ntoutges/GBG_MotorInterface/GBG_Motors.kicad_pcb

## KiCad design GBG_Motors.kicad_pcb (2026-10-02)

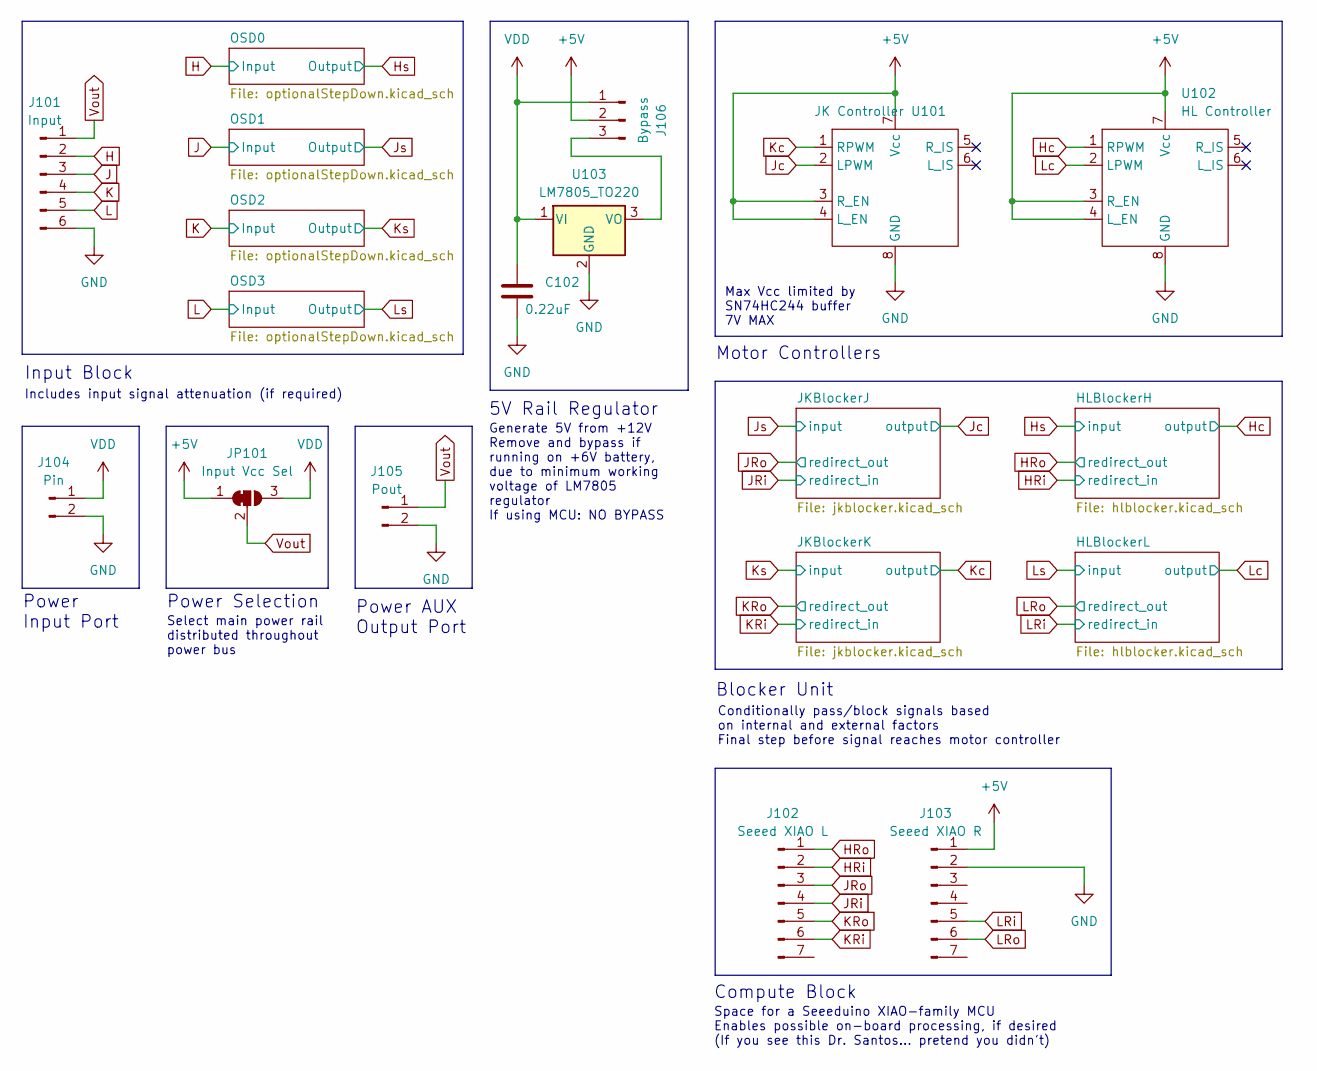
[picture p1: schematic GBG_Motors.kicad_sch]

Parts:
C102: 0.22uF; C_Axial_L3.8mm_D2.6mm_P7.50mm_Horizontal
J101: Input; PinHeader_1x06_P2.54mm_Vertical
J102: Seeed XIAO L; PinHeader_1x07_P2.54mm_Vertical
J103: Seeed XIAO R; PinHeader_1x07_P2.54mm_Vertical
J104: Pin; PinHeader_1x02_P2.54mm_Vertical
J105: Pout; PinHeader_1x02_P2.54mm_Vertical
J106: Bypass; PinHeader_1x03_P2.54mm_Vertical
JP101: Input Vcc Sel; SolderJumper-3_P1.3mm_Bridged12_RoundedPad1.0x1.5mm
U101: JK Controller; BTS7960
U102: HL Controller; BTS7960
U103: LM7805_TO220; TO-220-3_Vertical

Connections:
+5V: J103.1, J106.2, JP101.1 (A), U101.3 (R_EN), U101.4 (L_EN), U101.7 (Vcc), U102.3 (R_EN), U102.4 (L_EN), U102.7 (Vcc); also elsewhere on the board
GND: C102.2, J101.6, J103.2, J104.2, J105.2, U101.8 (GND), U102.8 (GND), U103.2 (GND); also elsewhere on the board
H: J101.2; also elsewhere on the board
HRi: J102.2; also elsewhere on the board
HRo: J102.1; also elsewhere on the board
Hc: U102.1 (RPWM); also elsewhere on the board
J: J101.3; also elsewhere on the board
JRi: J102.4; also elsewhere on the board
JRo: J102.3; also elsewhere on the board
Jc: U101.2 (LPWM); also elsewhere on the board
K: J101.4; also elsewhere on the board
KRi: J102.6; also elsewhere on the board
KRo: J102.5; also elsewhere on the board
Kc: U101.1 (RPWM); also elsewhere on the board
L: J101.5; also elsewhere on the board
LRi: J103.5; also elsewhere on the board
LRo: J103.6; also elsewhere on the board
Lc: U102.2 (LPWM); also elsewhere on the board
unnamed: J106.3, U103.3 (VO)
VDD: C102.1, J104.1, J106.1, JP101.3 (B), U103.1 (VI)
Vout: J101.1, J105.1, JP101.2 (C); also elsewhere on the board

Notes on the sheet:
Compute Block
Conditionally pass/block signals based on internal and external factors Final step before signal reaches motor controller
Input Block
Max Vcc limited by SN74HC244 buffer 7V MAX
Includes input signal attenuation (if required)
Power AUX Output Port
5V Rail Regulator
Space for a Seeeduino XIAO-family MCU Enables possible on-board processing, if desired (If you see this Dr. Santos... pretend you didn't)
Generate 5V from +12V Remove and bypass if running on +6V battery, due to minimum working voltage of LM7805 regulator If using MCU: NO BYPASS
Power Selection
Select main power rail distributed throughout power bus
Blocker Unit
Motor Controllers
Power Input Port

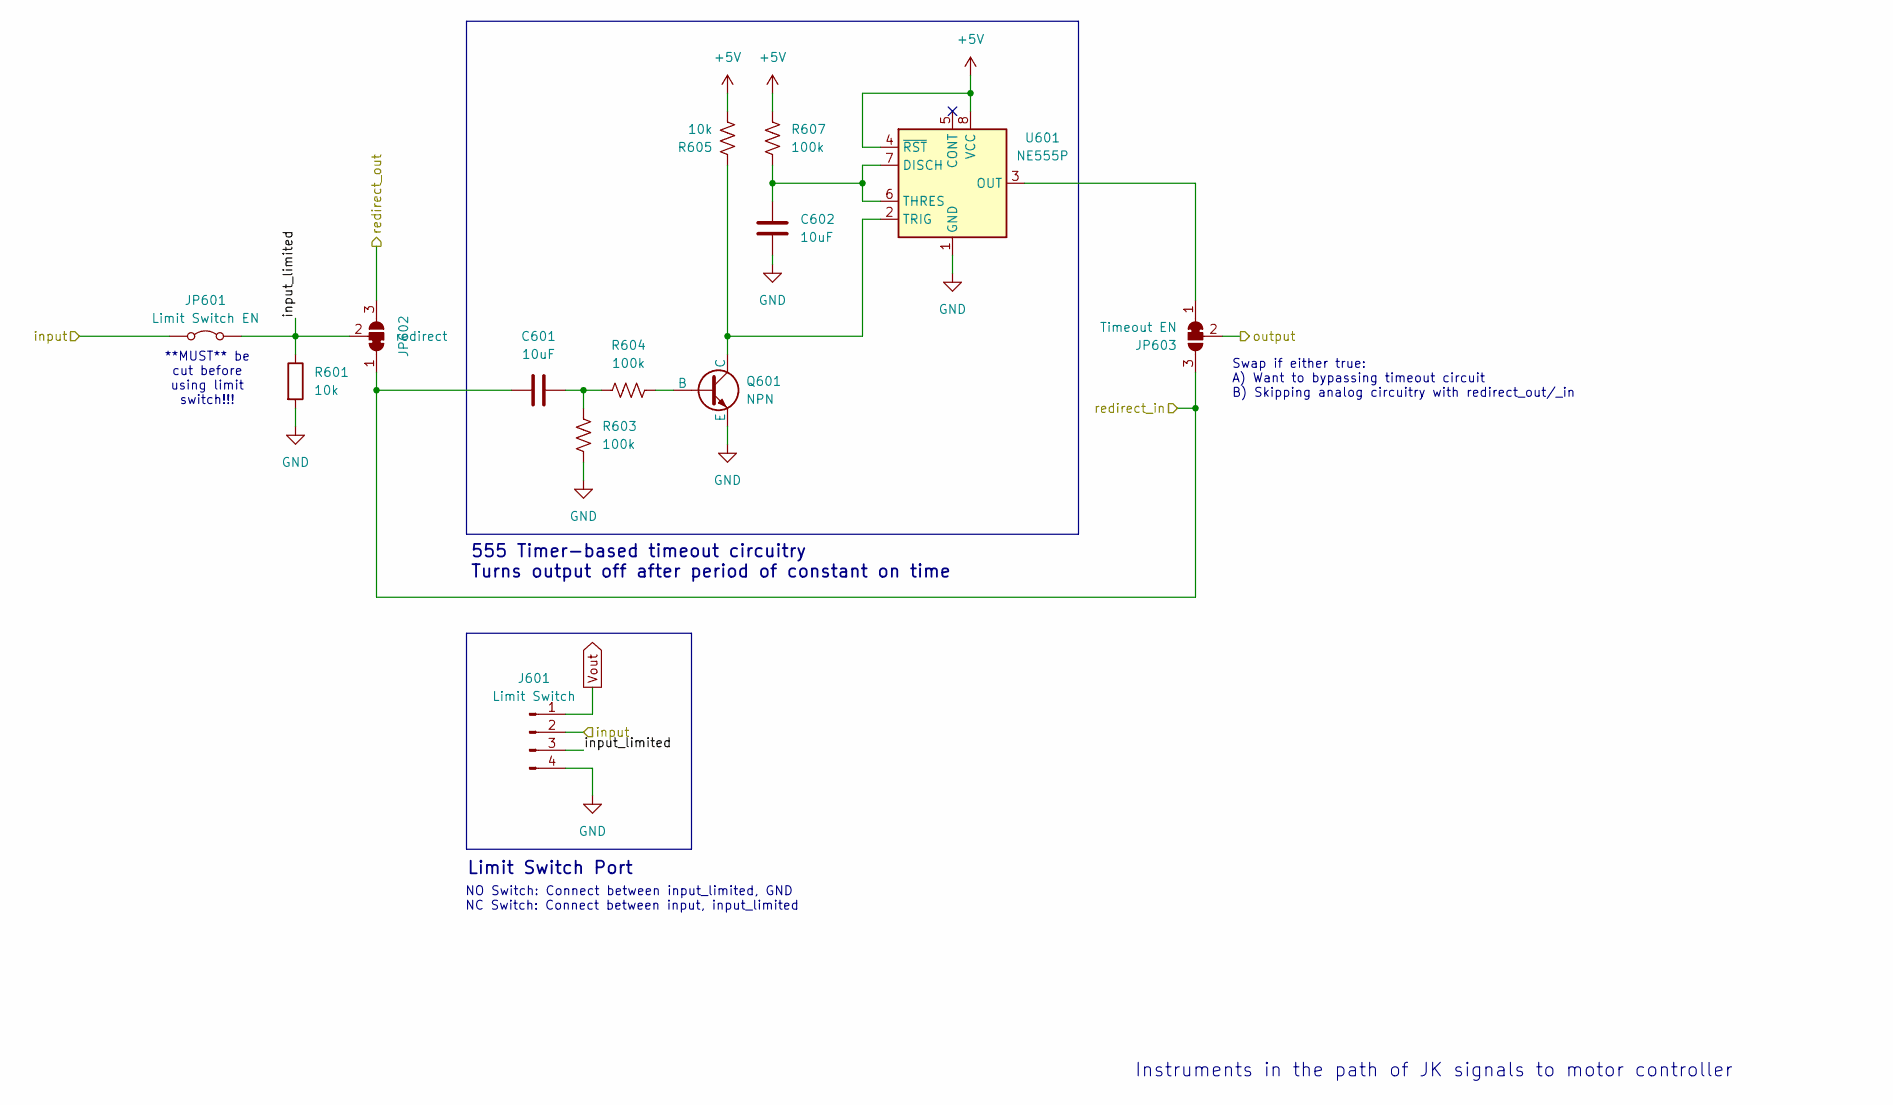
[picture p2: schematic hlblocker.kicad_sch]

Parts:
C601, C602: 10uF; C_Axial_L3.8mm_D2.6mm_P7.50mm_Horizontal
J601: Limit Switch; PinHeader_1x04_P2.54mm_Vertical
JP601: Limit Switch EN; SolderJumper-2_P1.3mm_Bridged_RoundedPad1.0x1.5mm
JP602: redirect; SolderJumper-3_P1.3mm_Bridged12_RoundedPad1.0x1.5mm
JP603: Timeout EN; SolderJumper-3_P1.3mm_Bridged12_RoundedPad1.0x1.5mm
Q601: NPN; TO-92_Wide
R601, R605: 10k; R_Axial_DIN0207_L6.3mm_D2.5mm_P7.62mm_Horizontal
R603, R604, R607: 100k; R_Axial_DIN0207_L6.3mm_D2.5mm_P7.62mm_Horizontal
U601: NE555P; DIP-8_W7.62mm

Connections:
+5V: R605.2, R607.1, U601.4 (~RST), U601.8 (VCC); also elsewhere on the board
/HLBlockerH/input_limited: J601.3, JP601.2 (B), JP602.2 (C), R601.1
GND: C602.2, J601.4, Q601.3 (E), R601.2, R603.2, U601.1 (GND); also elsewhere on the board
HRi: C601.1, JP602.1 (A), JP603.3 (B); also elsewhere on the board
HRo: JP602.3 (B); also elsewhere on the board
Hc: JP603.2 (C); also elsewhere on the board
Hs: J601.2, JP601.1 (A); also elsewhere on the board
unnamed: C601.2, R603.1, R604.1
unnamed: JP603.1 (A), U601.3 (OUT)
unnamed: Q601.2 (B), R604.2
unnamed: Q601.1 (C), R605.1, U601.2 (TRIG)
unnamed: C602.1, R607.2, U601.6 (THRES), U601.7 (DISCH)
Vout: J601.1; also elsewhere on the board

Parts of its further copies:
C701, C702: 10uF; C_Axial_L3.8mm_D2.6mm_P7.50mm_Horizontal
J701: Limit Switch; PinHeader_1x04_P2.54mm_Vertical
JP701: Limit Switch EN; SolderJumper-2_P1.3mm_Bridged_RoundedPad1.0x1.5mm
JP702: redirect; SolderJumper-3_P1.3mm_Bridged12_RoundedPad1.0x1.5mm
JP703: Timeout EN; SolderJumper-3_P1.3mm_Bridged12_RoundedPad1.0x1.5mm
Q701: NPN; TO-92_Wide
R701, R705: 10k; R_Axial_DIN0207_L6.3mm_D2.5mm_P7.62mm_Horizontal
R703, R704, R706: 100k; R_Axial_DIN0207_L6.3mm_D2.5mm_P7.62mm_Horizontal
U701: NE555P; DIP-8_W7.62mm

Connections of its further copies:
+5V: R705.2, R706.1, U701.4 (~RST), U701.8 (VCC); also elsewhere on the board
/HLBlockerL/input_limited: J701.3, JP701.2 (B), JP702.2 (C), R701.1
GND: C702.2, J701.4, Q701.3 (E), R701.2, R703.2, U701.1 (GND); also elsewhere on the board
LRi: C701.1, JP702.1 (A), JP703.3 (B); also elsewhere on the board
LRo: JP702.3 (B); also elsewhere on the board
Lc: JP703.2 (C); also elsewhere on the board
Ls: J701.2, JP701.1 (A); also elsewhere on the board
unnamed: C701.2, R703.1, R704.1
unnamed: JP703.1 (A), U701.3 (OUT)
unnamed: Q701.2 (B), R704.2
unnamed: Q701.1 (C), R705.1, U701.2 (TRIG)
unnamed: C702.1, R706.2, U701.6 (THRES), U701.7 (DISCH)
Vout: J701.1; also elsewhere on the board

Notes on the sheet:
**MUST** be cut before using limit switch!!!
555 Timer-based timeout circuitry Turns output off after period of constant on time
Instruments in the path of JK signals to motor controller
NO Switch: Connect between input_limited, GND NC Switch: Connect between input, input_limited
Limit Switch Port
Swap if either true: A) Want to bypassing timeout circuit B) Skipping analog circuitry with redirect_out/_in

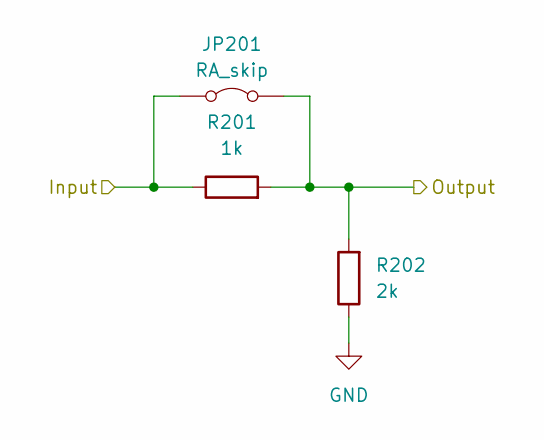
[picture p3: schematic optionalStepDown.kicad_sch]

Parts:
JP201: RA_skip; SolderJumper-2_P1.3mm_Bridged_RoundedPad1.0x1.5mm
R201: 1k; R_Axial_DIN0207_L6.3mm_D2.5mm_P7.62mm_Horizontal
R202: 2k; R_Axial_DIN0207_L6.3mm_D2.5mm_P7.62mm_Horizontal

Connections:
GND: R202.1; also elsewhere on the board
H: JP201.1 (A), R201.1; also elsewhere on the board
Hs: JP201.2 (B), R201.2, R202.2; also elsewhere on the board

Parts of its further copies:
JP301, JP401, JP501: RA_skip; SolderJumper-2_P1.3mm_Bridged_RoundedPad1.0x1.5mm
R301, R401, R501: 1k; R_Axial_DIN0207_L6.3mm_D2.5mm_P7.62mm_Horizontal
R302, R402, R502: 2k; R_Axial_DIN0207_L6.3mm_D2.5mm_P7.62mm_Horizontal

Connections of its further copies:
GND: R302.1, R402.1, R502.1; also elsewhere on the board
J: JP301.1 (A), R301.1; also elsewhere on the board
Js: JP301.2 (B), R301.2, R302.2; also elsewhere on the board
K: JP401.1 (A), R401.1; also elsewhere on the board
Ks: JP401.2 (B), R401.2, R402.2; also elsewhere on the board
L: JP501.1 (A), R501.1; also elsewhere on the board
Ls: JP501.2 (B), R501.2, R502.2; also elsewhere on the board

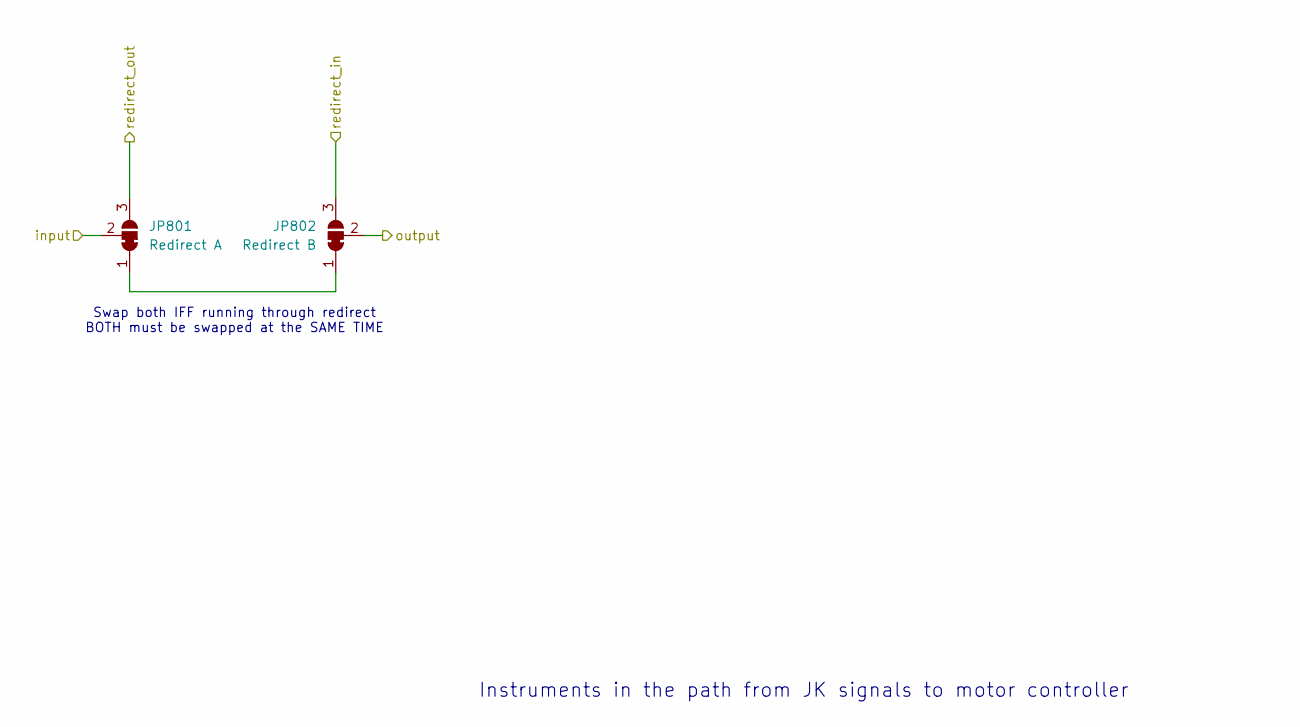
[picture p4: schematic jkblocker.kicad_sch]

Parts:
JP801: Redirect A; SolderJumper-3_P1.3mm_Bridged12_RoundedPad1.0x1.5mm
JP802: Redirect B; SolderJumper-3_P1.3mm_Bridged12_RoundedPad1.0x1.5mm

Connections:
JRi: JP802.3 (B); also elsewhere on the board
JRo: JP801.3 (B); also elsewhere on the board
Jc: JP802.2 (C); also elsewhere on the board
Js: JP801.2 (C); also elsewhere on the board
unnamed: JP801.1 (A), JP802.1 (A)

Parts of its further copies:
JP901: Redirect A; SolderJumper-3_P1.3mm_Bridged12_RoundedPad1.0x1.5mm
JP902: Redirect B; SolderJumper-3_P1.3mm_Bridged12_RoundedPad1.0x1.5mm

Connections of its further copies:
KRi: JP902.3 (B); also elsewhere on the board
KRo: JP901.3 (B); also elsewhere on the board
Kc: JP902.2 (C); also elsewhere on the board
Ks: JP901.2 (C); also elsewhere on the board
unnamed: JP901.1 (A), JP902.1 (A)

Notes on the sheet:
Instruments in the path from JK signals to motor controller
Swap both IFF running through redirect BOTH must be swapped at the SAME TIME

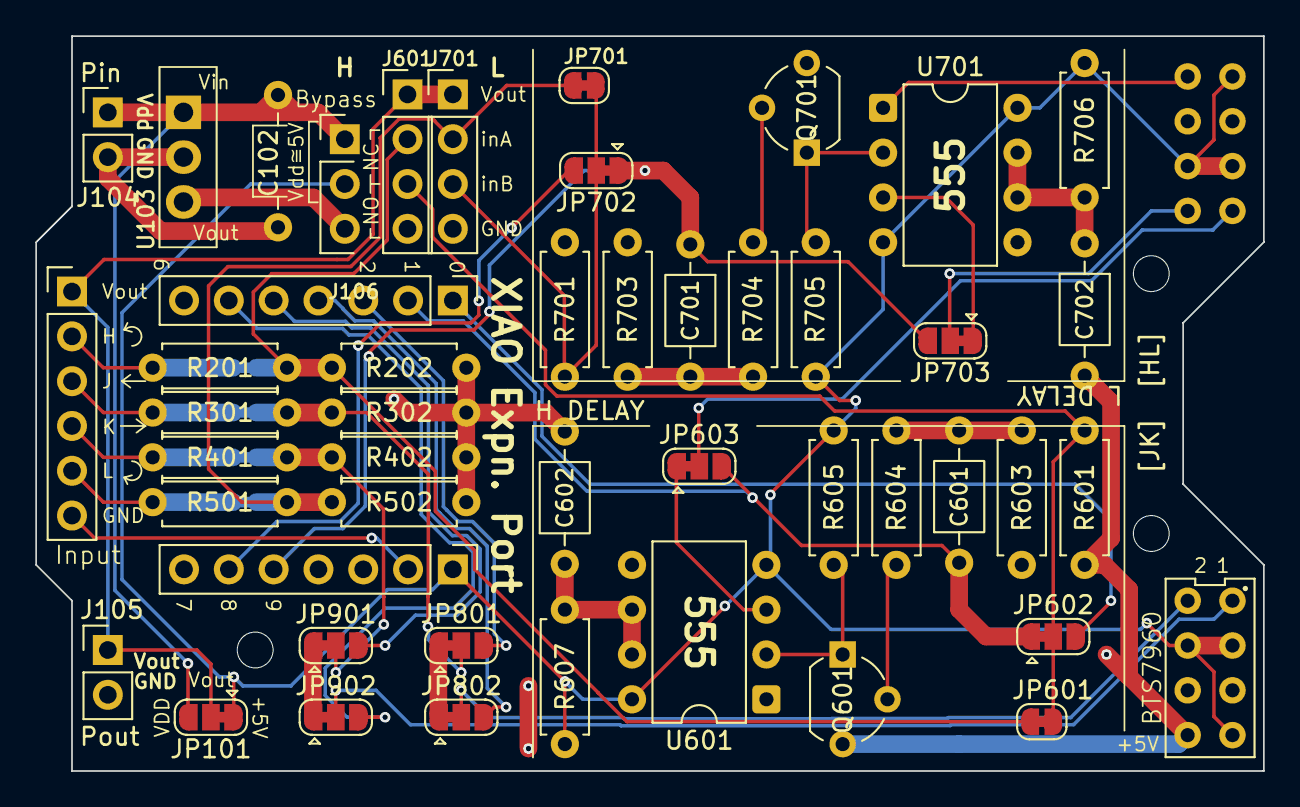
[picture p5: board GBG_Motors.kicad_pcb from above]

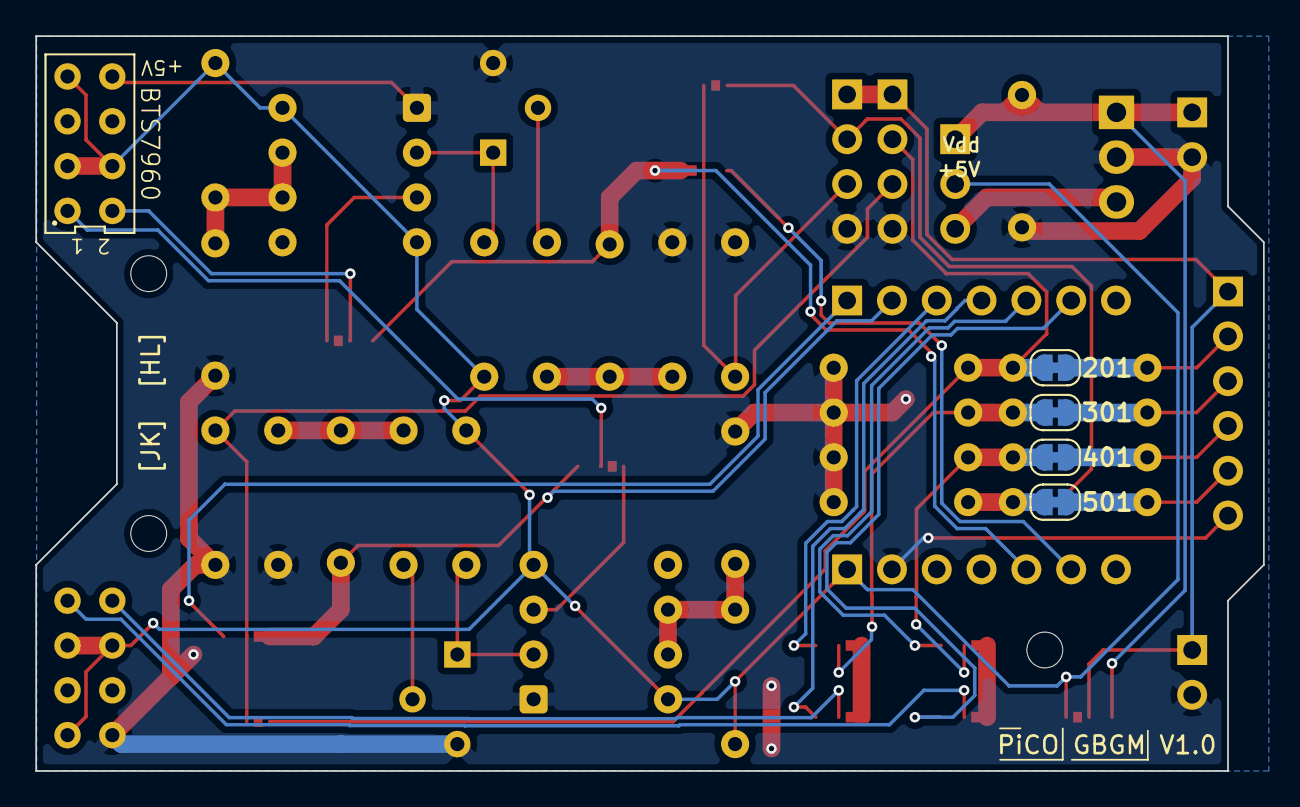
[picture p6: board GBG_Motors.kicad_pcb from below]

Board: 2 copper layers, 69.6 x 41.7 mm, 53 parts (5 on the bottom side), 39 nets.
