ntoutges/GBG_MotorInterface/(commit log)

2026-09-30 Initial commit
    Created custom library for 2x BTS7960 HBridge Motor Controller
    [GBG_Motors.kicad_pcb, GBG_Motors.kicad_sch]
2026-10-01 Began layout phase
    [GBG_Motors.kicad_pcb]
2026-10-01 Fixed critical missing files
    [GBG_Motors.kicad_sch, hlblocker.kicad_sch, jkblocker.kicad_sch, optionalStepDown.kicad_sch]
2026-10-01 Finished initial board design
    [GBG_Motors.kicad_pcb, GBG_Motors.kicad_sch, hlblocker.kicad_sch, jkblocker.kicad_sch, optionalStepDown.kicad_sch]
2026-10-01 Replaced VDD/5V passthru with fully-fledged pin header
    [GBG_Motors.kicad_pcb, GBG_Motors.kicad_sch]
2026-10-01 Updated bypass jumper's silkscreen label position
    [GBG_Motors-B_Cu.gbr, GBG_Motors-B_Mask.gbr, GBG_Motors-B_Paste.gbr, GBG_Motors-B_Silkscreen.gbr, GBG_Motors-Edge_Cuts.gbr, GBG_Motors-F_Cu.gbr, GBG_Motors-F_Mask.gbr, GBG_Motors-F_Paste.gbr]
2026-10-01 Updated bypass jumper pin header model
    [GBG_Motors.kicad_sch]
2026-10-01 Added bypass capacitor
    [GBG_Motors.kicad_pcb, GBG_Motors.kicad_sch, hlblocker.kicad_sch, jkblocker.kicad_sch, optionalStepDown.kicad_sch]
2026-10-02 Final changes based on BoM
    [GBG_Motors.kicad_pcb, hlblocker.kicad_sch, optionalStepDown.kicad_sch]
